createprogect08/Campionati-di-Robotica-Ocean-Edition-2025/prezzi.pdf

# Prezzo materiali

nome materiale: | quantitativo: | link: | materiale già disponibile: | costo: | costo (molt): | mat. Effe. Costo: | utilizzo:
PETG (filamento stampante 3d) | 2kg | link (https://amzn.eu/d/bscW3f8) | | 27,54 | 27,54 | 27,54 | per fare la scocca esterna del drone
fotocamera HD usb | 1 | link (https://amzn.eu/d/2YRDuEB) | | 12,99 | 12,99 | 12,99 | per visualizzare l' area marina
Rasberry Pi 5 (4gb ram) | 1 | link (https://amzn.eu/d/4NblSKU) | | 75,53 | 75,53 | | per rieleborare i dati e trasmetterli al pc
connettore waterproof ethernet | 1 | link (https://it.aliexpress.com/item/1005007055829784.html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) | | 7,69 | 7,69 | 7,69 | per evitare l' entrata della corrente
turbina waterproof (motore DC) (modello CW) | 2 | link (https://it.aliexpress.com/item/1005006865847918.html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) | | 18,5 | 37 | 37 | per far girare il robot
turbina waterproof (motore DC) (modello CCW) | 3 | link (https://it.aliexpress.com/item/1005006865847918.html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) | (1 già in possesso) | 18,5 | 37 | 37 | per far abbassare e alzare il robot
drive per le turbine (esc almeno 20A) | 1 | link (https://a.aliexpress.com/_EwTCxxG) | | 19,39 | 19,39 | 19,39 | per gestire i motori
Celle di litio (18650) | 21 | link (https://it.aliexpress.com/item/1005007548114492.html?scm_id=1007.40196.436742.0&scm-url=1007.40196.436742.0) | | 5,7 | 119,7 | | alimentare il robot
giroscopio (MPU-6050) | 1 | link (https://it.aliexpress.com/item/1005007531942608.html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) | | 2,89 | 2,89 | | orientare il robot
cavo ethernet water proof | 5m | link (https://it.aliexpress.com/item/1005004323828893.html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) | | 3,55 | 3,55 | | collegarsi al robot
sensore TDS (Keyestudio) | 1 | link (https://it.aliexpress.com/item/33050818416.html?src=google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) | | 9,03 | 9,03 | 9,03 | dati riguardati la qualità del acqua
arduino mega | 1 | link (https://www.amazon.it/Elegoo-ATmega2560-ATMEGA16U2-Compatibile-Arduino/dp/B071W7WP35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) | | 30,5 | 30,5 | | ricevere i valori dei sensori
sensore pressione (0-0.5Mpa) | 1 | link (https://it.aliexpress.com/item/1005006388968074.html?src=google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) | | 10,59 | 10,59 | 10,59 | capire la distanza di profondità
riduttore tensione (to 5v) | 1 | link (https://it.aliexpress.com/item/1005006036679284.html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) | | 3,19 | 3,19 | | alimentare il Rasberry pi 5
corda | 5m | link (https://it.aliexpress.com/item/1005008286367846.html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) | | 2,16 | 2,16 | | in caso di emergenza recuperare il robot
plexgras | 30cmx30cm | link (https://pannelliplastica.it/prodotto/plexiglass-trasparente-economico-2-mm/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) | | 20 | 20 | | per protegge luci e fotocamera
illuminazione led 24v strisce | 1m (il minimo) | link (https://it.aliexpress.com/item/1005007864657883.html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) | | 1,5 | 1,5 | | illuminare il territorio marino
tubo | d = 80mm, l = 250mm | link (https://www.amazon.it/DMiotech-Trasparente-Acrilico-Raffreddamento-Idraulico/dp/B0C1SN77KL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) | | 21,01 | 21,01 | 21,01 | dove inseriamo l' elettronica per evitare il corto
cavo usb | 5m | link (https://it.aliexpress.com/item/1005007038160833.html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) | | 13,79 | 13,79 | 13,79 | per trasmettere alimentazione e dati
gps | 1 | link (https://it.aliexpress.com/item/1005007175919889.html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) | | 3,06 | 3,06 | 3,06 | per visualizzare la posizione
modulo ethernet | 1 | link (https://it.aliexpress.com/item/1005004679288698.html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) | | 4,31 | 4,31 | | per la comunicazione con il rasberry pi
modulo gestione celle | 1 | link (https://amzn.eu/d/h0YUxmm) | | 7,49 | 7,49 | 7,49 | per evitare il corto o instabilità nel pacco batteria
pulsante accensione | 1 | link (https://it.aliexpress.com/item/1005007267460972.html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) | | 2,47 | 2,47 | 2,47 | per accendere la struttura
guine impermeabili | 1 | link (https://www.amazon.it/Romon-Termorestringente-Elettrici-Rapporto-Restringimento/dp/B0C68PR69Q) | | 7,99 | 7,99 | 7,99 | per isolare i cavi sott' acqua
drive per le turbine (esc almeno 20A) | 1 | link (https://it.aliexpress.com/item/1005006457352568.html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) | | 14,99 | 14,99 | 14,99 | per gestire i motori
Totale: | | | | | 495,36 | 232,03

cose non contare (già presenti)
cavi vari
colla a caldo
viti e dadi
silicone
