createprogect08/Campionati-di-Robotica-Ocean-Edition-2025/modulistica/altre_info.txt

Innovazione tecnologica e creatività (30%)  
Impatto ambientale e coerenza con il tema (30%)  
Collegamento con le attività di citizen science (20%)  
Chiarezza della documentazione e della presentazione (20%)
