createprogect08/Campionati-di-Robotica-Ocean-Edition-2025/modulistica/elenco_art_vietati.png

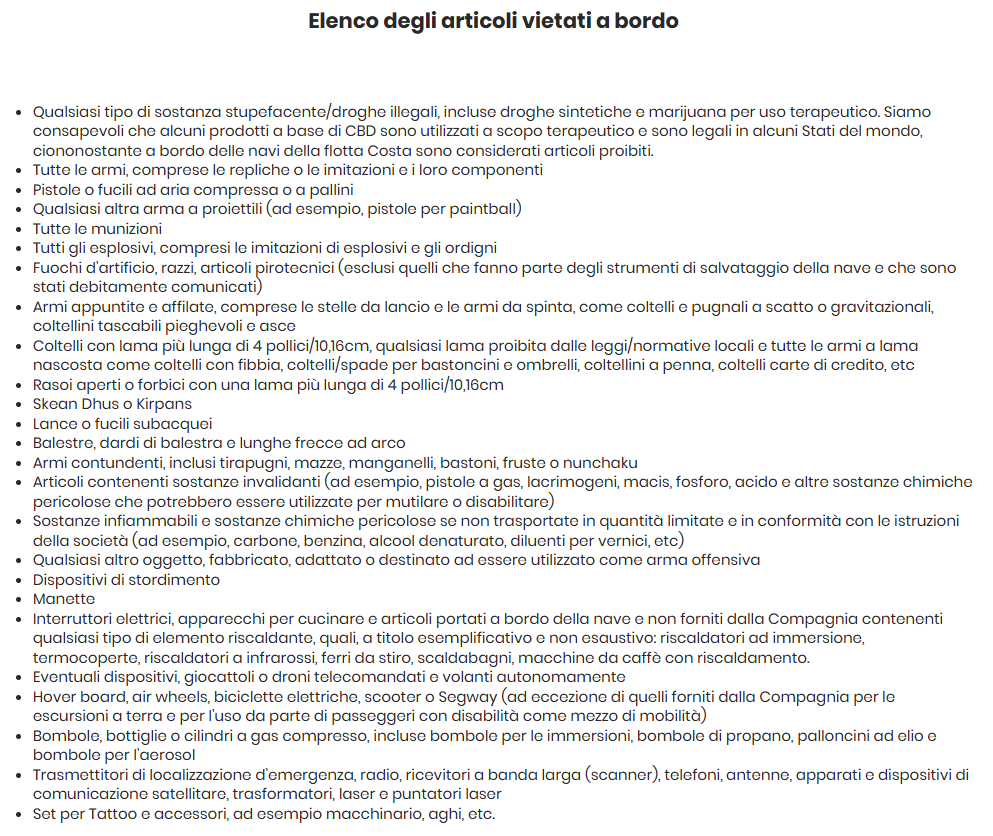
modulistica/elenco_art_vietati.png
