createprogect08/Campionati-di-Robotica-Ocean-Edition-2025/progetto/elettronica/elettronica_boa/collegamento_boa.png

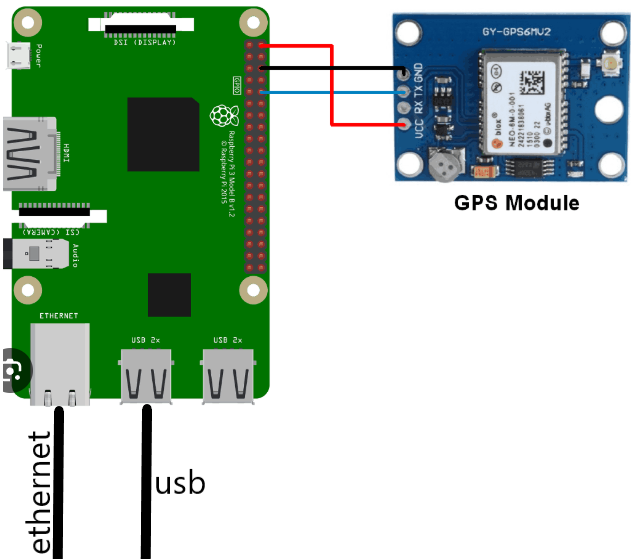
progetto/elettronica/elettronica_boa/collegamento_boa.png
