createprogect08/Campionati-di-Robotica-Ocean-Edition-2025/progetto/elettronica/elettronica_sottomarino/batterie/modello_realizzato/IMG-20250426-WA0004.jpg

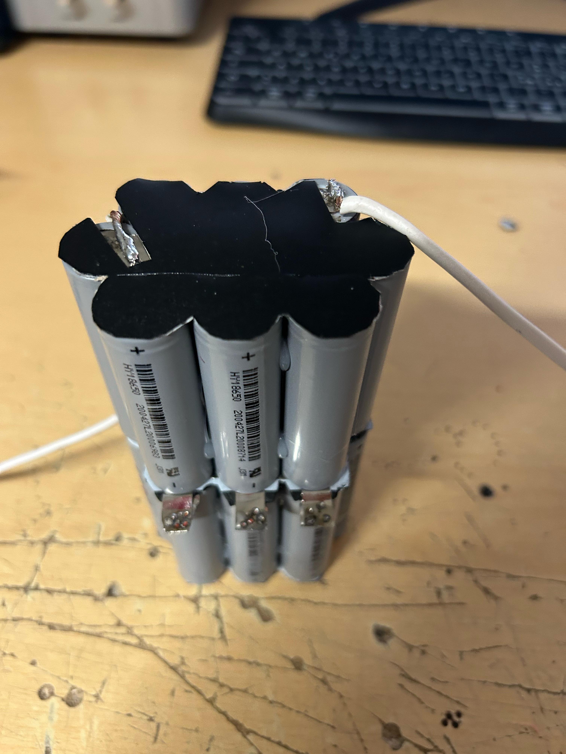
progetto/elettronica/elettronica_sottomarino/batterie/modello_realizzato/IMG-20250426-WA0004.jpg
