createprogect08/Campionati-di-Robotica-Ocean-Edition-2025/progetto/elettronica/elettronica_sottomarino/schema_sottomarino.jpg

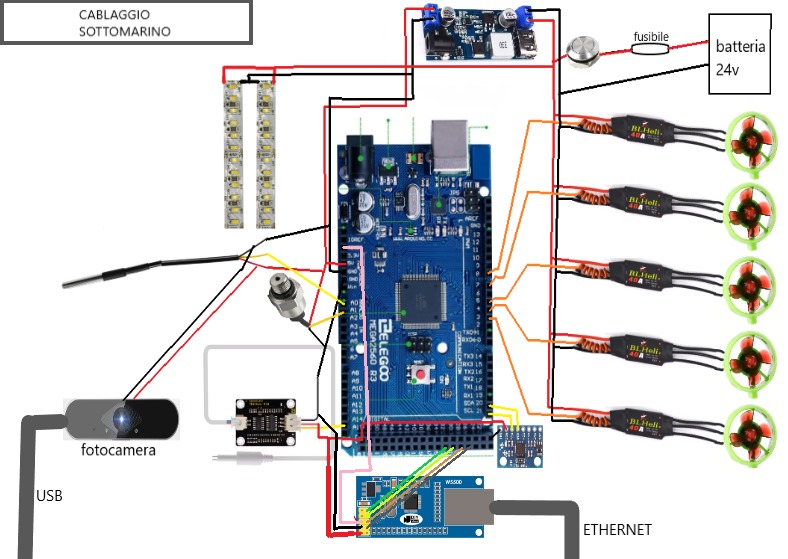
progetto/elettronica/elettronica_sottomarino/schema_sottomarino.jpg
