createprogect08/Campionati-di-Robotica-Ocean-Edition-2025/progetto/modello_3D/scocca_sottomarino/file_3D/modello drone subbaqueo/tinker.obj

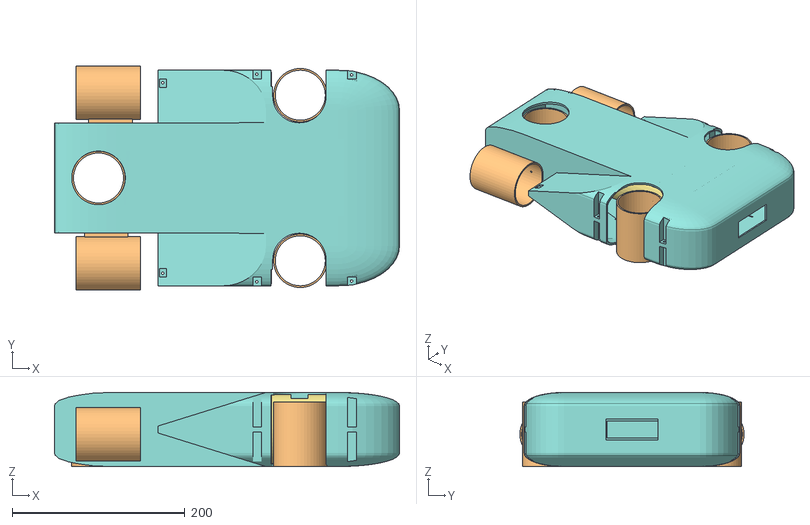
[picture p18: CAD file, 2025-05-04]
progetto/modello_3D/scocca_sottomarino/file_3D/modello drone subbaqueo/tinker.obj
400.0 x 260.0 x 86.0
