createprogect08/Campionati-di-Robotica-Ocean-Edition-2025/progetto/modello_3D/scocca_boa/file_3D/boa.stl

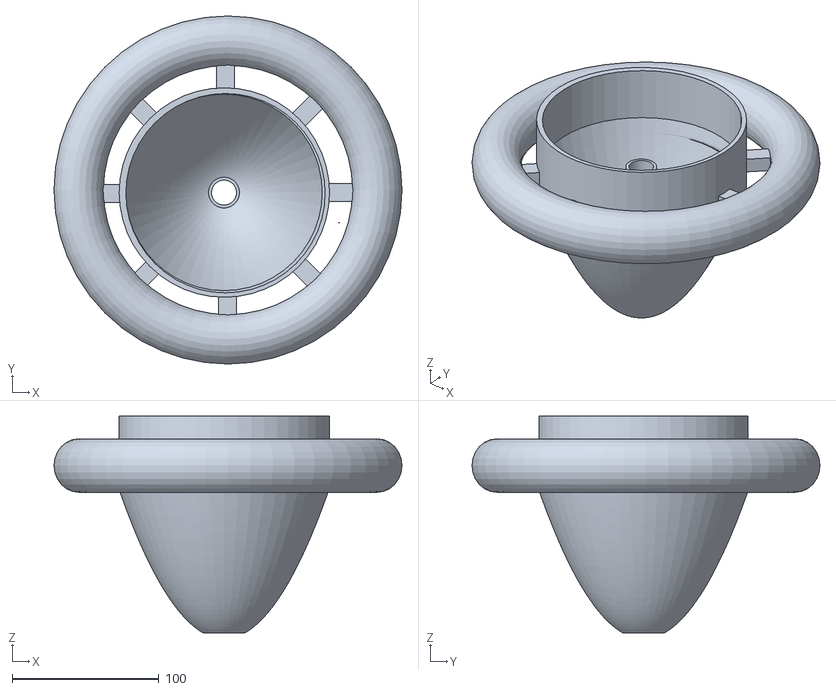
[picture p20: CAD file, 2025-05-06]
progetto/modello_3D/scocca_boa/file_3D/boa.stl
237.5 x 237.5 x 148.0
