createprogect08/Campionati-di-Robotica-Ocean-Edition-2025/progetto/modello_3D/scocca_sottomarino/file_3D/modello drone subbaqueo (4).stl

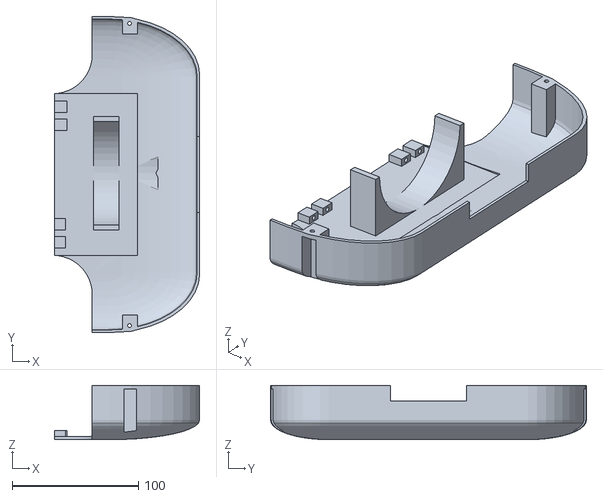
[picture p21: CAD file, 2025-05-04]
progetto/modello_3D/scocca_sottomarino/file_3D/modello drone subbaqueo (4).stl
115.0 x 250.0 x 43.0
