createprogect08/Campionati-di-Robotica-Ocean-Edition-2025/progetto/modello_3D/scocca_sottomarino/file_3D/modello drone subbaqueo (1).stl

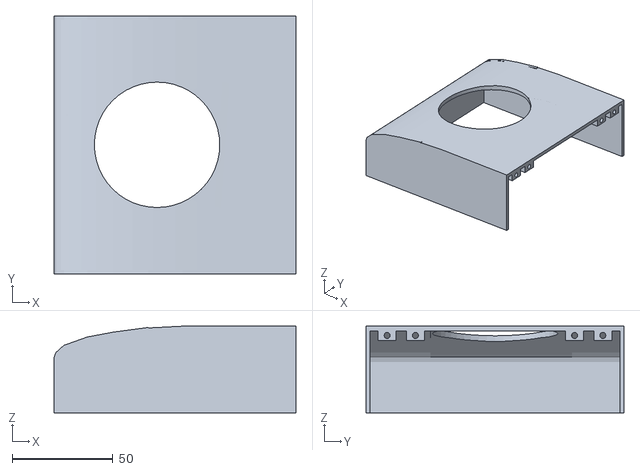
[picture p22: CAD file, 2025-05-04]
progetto/modello_3D/scocca_sottomarino/file_3D/modello drone subbaqueo (1).stl
120.0 x 128.0 x 43.0
