createprogect08/Campionati-di-Robotica-Ocean-Edition-2025/progetto/modello_3D/scocca_boa/file_3D/boa (2).stl

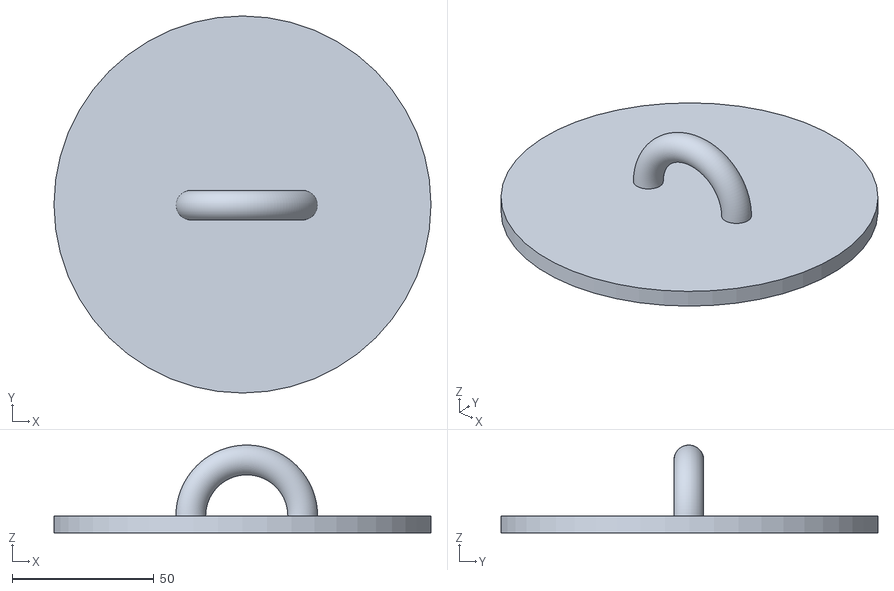
[picture p23: CAD file, 2025-05-06, an earlier design]
progetto/modello_3D/scocca_boa/file_3D/boa (2).stl
133.0 x 133.0 x 31.0
