createprogect08/Campionati-di-Robotica-Ocean-Edition-2025/progetto/modello_3D/scocca_boa/file_3D/boa (1).stl

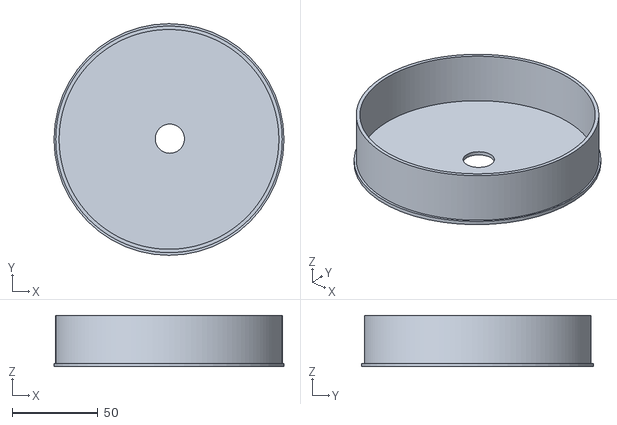
[picture p24: CAD file, 2025-05-06, an earlier design]
progetto/modello_3D/scocca_boa/file_3D/boa (1).stl
134.0 x 135.0 x 30.0
