createprogect08/Campionati-di-Robotica-Ocean-Edition-2025/(list of files, cad)

Other CAD files:
progetto/modello_3D/scocca_sottomarino/file_3D/modello drone subbaqueo (2).stl
progetto/modello_3D/scocca_sottomarino/file_3D/modello drone subbaqueo (6).stl
