createprogect08/Campionati-di-Robotica-Ocean-Edition-2025/(commit log)

2025-05-04 undicesimo commit
    [boa (1).stl, boa (2).stl, boa.stl]
2025-05-04 tredicesimo commit
    [boa (1).stl, boa (2).stl, boa.stl]
2025-05-04 quattordicesimo commit
    [modello drone subbaqueo (1).stl, modello drone subbaqueo (2).stl, modello drone subbaqueo (3).stl, modello drone subbaqueo (4).stl, modello drone subbaqueo (5).stl, modello drone subbaqueo (6).stl, tinker.obj]
2025-05-06 Aggiunta file CSV con prezzi dei materiali e documentazione per il pacco batteria, script sottomarino e modelli 3D
    [boa (1).stl, boa (2).stl, boa.stl, prezzi - Foglio1.csv]
